andreasschegg/Door/hardware/esp-pinout.png

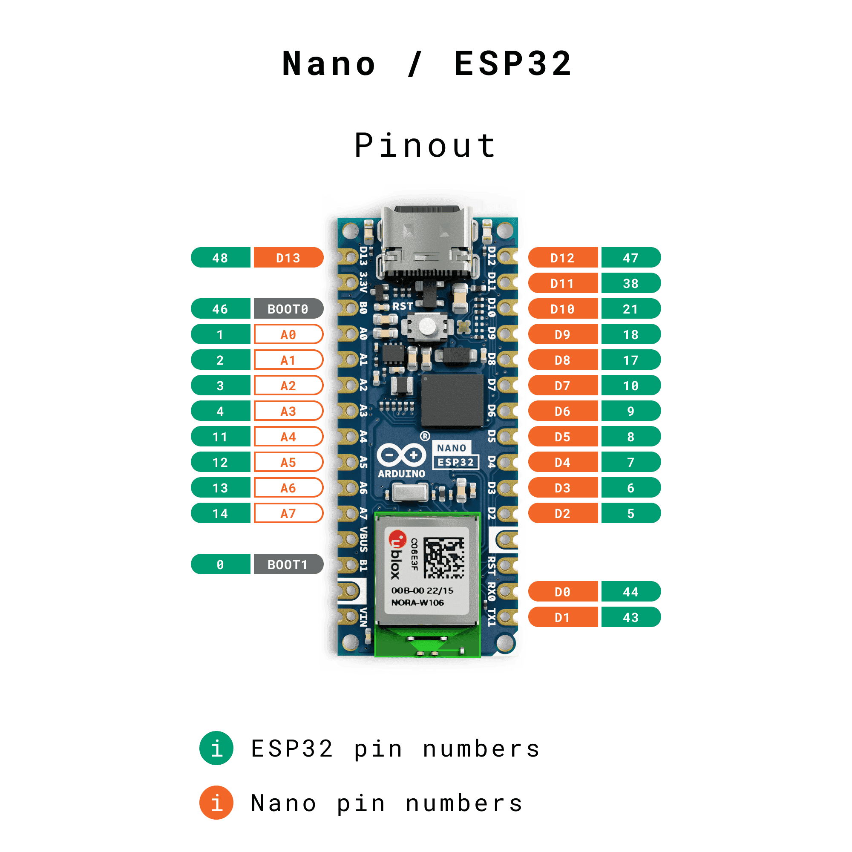
hardware/esp-pinout.png
