andreasschegg/Door/hardware/bb-stop-test.stl

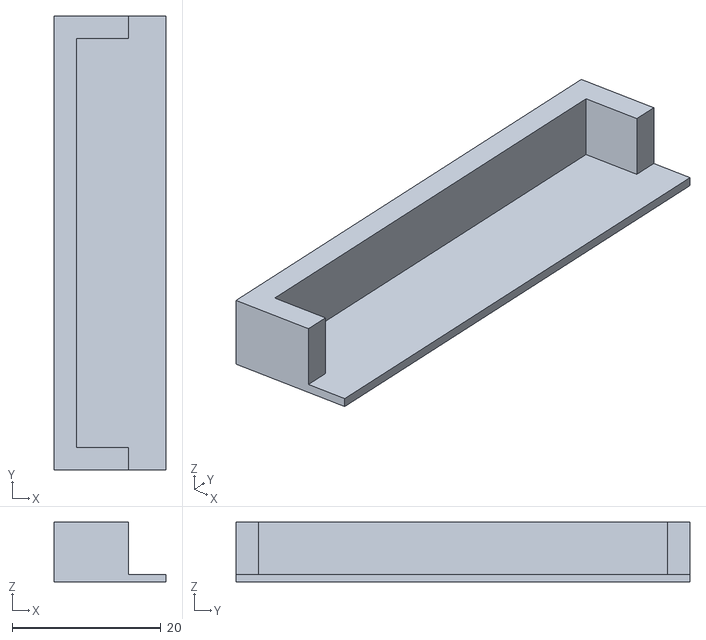
[picture p2: CAD file, 2026-03-22]
hardware/bb-stop-test.stl
15.0 x 61.0 x 8.00
