andreasschegg/Door/hardware/test-platform.stl

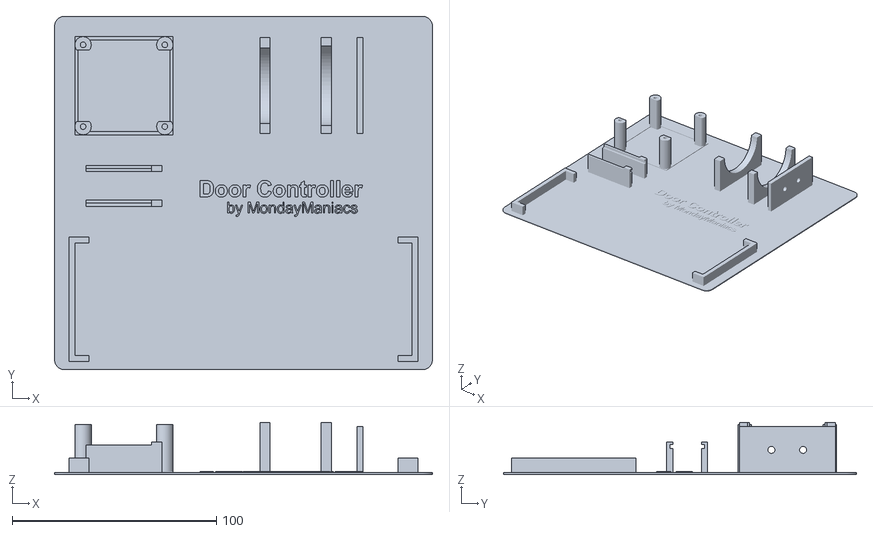
[picture p3: CAD file, 2026-03-22]
hardware/test-platform.stl
185.0 x 173.0 x 25.5
