andreasschegg/Door/hardware/motor-wall-test.stl

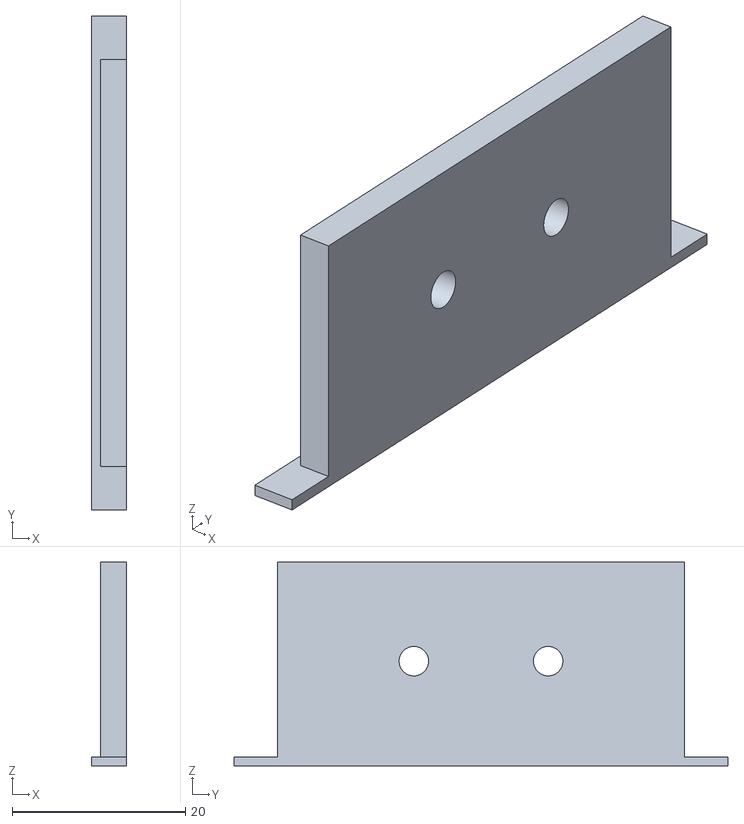
[picture p4: CAD file, 2026-03-22]
hardware/motor-wall-test.stl
4.00 x 57.0 x 23.5
