andreasschegg/Door/hardware/buck-socket-test.stl

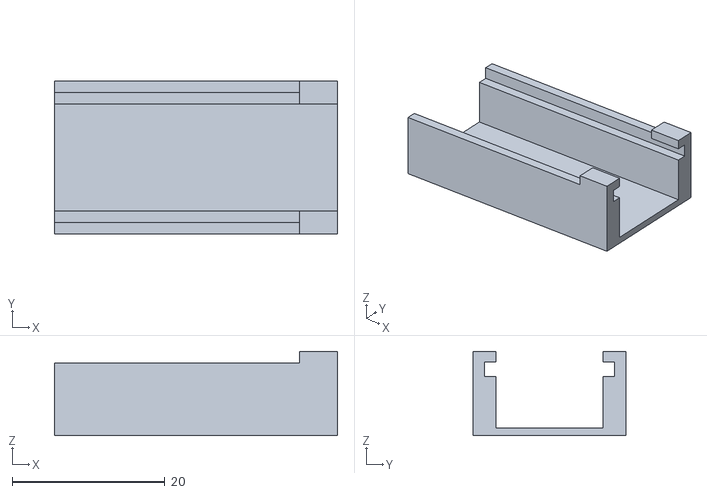
[picture p5: CAD file, 2026-03-22]
hardware/buck-socket-test.stl
37.0 x 20.0 x 11.0
