andreasschegg/Door/(commit log)

2026-03-14 Initial commit: ESP32 Door Controller
    - BTS7960 H-Bridge motor driver with abstract interface for easy swap
    - DoorController state machine (CLOSED/OPENING/OPEN/CLOSING/STOPPED/ERROR)
    - Soft-start PWM ramp, overcurrent detection, timeout safety
    - Web UI with live status and Open/Close/Stop/Reset controls
    - ArduinoOTA for wireless firmware updates
    - mDNS (http://door.local)
    [BTS7960Driver.cpp, BTS7960Driver.h, Config.h, DoorController.cpp, DoorController.h, MotorDriver.h]
2026-03-14 Add circuit protection docs and adjust current threshold for voltage divider
    - CIRCUIT.md: Full circuit documentation with component rationale
    - Config.h: CURRENT_THRESHOLD adjusted from 2000 to 1333 to account
    for the 10kΩ/20kΩ voltage divider on IS pins (factor 0.667)
2026-03-14 Add graphical circuit schematic (SVG)
    - Color-coded wiring: 12V (red), 5V (orange), signals (green/blue), GND (gray)
    - All protection components shown inline with values
    - Legend and annotations explaining each protection measure
2026-03-15 Redesign schematic for print: larger text, A3 landscape format
    - All font sizes increased ~1.7x for readability
    - Canvas sized for A3 landscape printing (420mm × 297mm)
    - Print CSS added for clean page output
    - Component symbols and spacing scaled up proportionally
2026-03-15 Redraw schematic: strict Manhattan routing, no overlaps
    - All wires strictly horizontal or vertical (no diagonal lines)
    - ESP32 and BTS7960 pins aligned at same y-coordinates for straight
    horizontal connections
    - Pull-down resistors staggered at x=640/760/880/1000 to avoid
    overlap with adjacent wires (70px spacing, 62px component height)
    - Voltage dividers for R_IS and L_IS at different x-positions
    (x=1260 and x=1100) to prevent vertical overlap
    - Motor M+/M- routed with proper right-angle corners
    - Endstop wires routed vertical-then-horizontal from GPIO pins
2026-03-15 Fix schematic: remove 5V/12V short circuit, reposition annotation
    - 5V rail now ends at x=1540 (VCC junction) instead of x=1580
    where it crossed the 12V vertical line to B+
    - Pull-down annotation moved from y=810 to y=778, clearing the
    R_IS wire at y=830
2026-03-15 Widen legend box and shift symbol column to prevent text overlap
    - Legend box width 520 → 650px
    - Symbol column shifted from x=1400 to x=1530, clearing the
    long 'Motor-Steuerung (PWM / Enable)' text on the left
2026-03-15 Move OPEN/CLOSE labels above their endstop wires
2026-03-15 Implement Approach B: DFRobot FIT0185 encoder motor support
    - New Encoder class using ESP32 PCNT hardware for quadrature decoding
    (2096 CPR, overflow handling, RPM calculation, auto-detection)
    - DoorController: CALIBRATING state, NVS persistence, position-based
    stopping, encoder auto-detect with graceful fallback to endstop-only
    - Web UI: position bar, RPM display, calibrate/clear buttons, encoder
    status indicators
    - Config: FIT0185 parameters (5A current threshold, 1200ms ramp,
    25s timeout), encoder pins GPIO 16/17
    - CIRCUIT.md: encoder wiring with level shifter, updated parts list,
    PSU 5A, calibration instructions
    - Compile-time ENCODER_ENABLED flag for backward compatibility
    Co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
2026-03-15 Update schematic: add encoder, level shifter, DFRobot FIT0185
    - ESP32 block extended with Encoder section (GPIO 16/17, purple)
    - Level Shifter block (BSS138, 5V→3.3V) between ESP32 and motor
    - Encoder signals routed with 1kΩ+100nF RC filters through level
    shifter, then under BTS7960 to motor encoder pins
    - Motor block updated: DFRobot FIT0185 with encoder pin labels
    - 5V rail supplies level shifter and encoder VCC
    - PSU updated to min. 5A
    - Legend: encoder color (purple) added
    - Footer: v2.0
2026-03-15 Remove level shifter — not needed for this use case
    1kΩ series resistor limits clamp diode current to ~1.7mA, safe for
    ESP32 inputs with 5V encoder signals. Level shifter only warranted
    for 24/7 continuous operation, not 30-40 cycles per evening.
2026-03-15 Fix encoder 5V line: route from 5V rail to motor encoder VCC
    Line was ending mid-air with old level shifter label. Now routed
    properly down and right to the motor encoder block.
2026-03-15 Reroute BTS7960 power connections to right side, add B-/GND
    - VCC (5V) and B+ (12V) now enter from the right side of the
    BTS7960 box via Manhattan routing, matching the '← 5V' / '← 12V'
    labels inside the block
    - B-/GND gets a proper pin stub on the right side with GND symbol
    - Removed old top-entry lines that pierced through the box border
2026-03-15 Redesign motor block: clear pin layout, separated connections
    - Motor+Encoder as proper block with title bar (like ESP32/BTS7960)
    - M+/M- pins on RIGHT side, routed from BTS7960 via x=2020/2060
    - Encoder Ch.A/B pins on LEFT side, connected to encoder wires
    - 5V pin on LEFT, GND pin on RIGHT with GND symbol
    - Clear divider between motor and encoder sections
    - Labels below block: FIT0185 specs + Encoder 2096 CPR
    - Endstops, legend, footer shifted down for larger canvas (1800px)
2026-03-15 Add complete bill of materials (BOM.md)
    Main components, protection circuitry, wiring/mounting supplies
    with estimated costs. Notes for motor alternatives (FIT0186, Waveshare).
2026-03-22 Change voltage divider from 20kΩ to 18kΩ (available in stock)
    - IS_R_BOTTOM: 20000 → 18000 Ohm
    - Divider ratio: 0.667 → 0.643 (3.21V max, safer margin)
    - CURRENT_THRESHOLD: 500 → 482 (same ~5A trip point)
    - Updated CIRCUIT.md calculations and BOM.md
2026-03-22 Add 3D-printable test platform (OpenSCAD)
    Mounting platform for test setup with:
    - Arduino Uno standoffs (4x M3, standard hole positions)
    - BTS7960 module standoffs (4x M3)
    - FIT0185 motor mount pad (6x M3 hex pattern, shaft hole)
    - Breadboard rails (165x55mm, side clips + front/back lips)
    - 15mm corner legs for motor shaft clearance below
    - Embossed component labels
    - Platform ~235x154mm, fits Prusa bed (250x210)
    [test-platform.scad]
2026-03-22 Switch from ESP32 to ESP32-S3-N16R8
    - platformio.ini: board esp32dev → esp32-s3-devkitc-1, COM3
    - Config.h: complete pin remap for S3 (GPIO 26-37 unavailable
    due to Octal Flash/PSRAM):
    RPWM: 25→4, LPWM: 26→5
    R_EN: 27→6, L_EN: 14→7
    R_IS: 34→1, L_IS: 35→2 (ADC1 channels)
    OPEN: 32→15, CLOSE: 33→16
    Enc.A: 16→17, Enc.B: 17→18
    - LEDC and PCNT APIs work unchanged on S3
2026-03-22 Update schematic, CIRCUIT.md and BOM for ESP32-S3 pin mapping
    - Schematic: all GPIO labels updated (25→4, 26→5, 27→6, 14→7,
    34→1, 35→2, 32→15, 33→16, 16→17, 17→18), title bar + subtitle
    updated to ESP32-S3
    - CIRCUIT.md: all pin references, overview text, ADC comments updated
    - BOM.md: ESP32 entry updated to ESP32-S3-N16R8 (44-Pin)
2026-03-22 Update remaining ESP32 references to ESP32-S3 in CIRCUIT.md
    Motor block pin labels (GPIO 17→17, 18→18) and all explanatory
    text sections updated to reference ESP32-S3 consistently.
2026-03-22 Switch to Arduino Nano ESP32 board
    - platformio.ini: board → arduino_nano_esp32, auto-detect USB port
    - Config.h: endstop pins remapped (GPIO 15/16 → GPIO 8/9, D5/D6)
    as GPIO 15-16 not exposed on Nano ESP32. All pins annotated with
    Nano pin names (A0-A3, D2-D9).
    - Schematic: title + ESP32 block label updated, GPIO 15→8, 16→9
    - CIRCUIT.md: all references updated to Arduino Nano ESP32
    - BOM.md: board entry updated
    - test-platform.scad: removed Uno mount, Nano plugs into breadboard,
    simpler layout (BTS7960 + Motor + Breadboard only)
    [test-platform.scad]
2026-03-22 Add STL export of test platform for PrusaSlicer
    153 x 143 mm platform, fits Prusa bed.
    Generated from test-platform.scad via OpenSCAD.
    [test-platform.stl]
2026-03-22 Redesign test platform: motor cradle + IBT_2 heatsink-down
    - Motor lies on its side in semicircular cradle with 3 support
    walls (left, middle, right) + 2 zip-tie bridges for securing
    - Shaft extends right beyond the platform
    - IBT_2 mounts heatsink-down with M3 through-holes, pins face up
    - Breadboard with side rails for Nano ESP32
    - Platform: 195 x 150 mm, fits Prusa bed
    [test-platform.scad, test-platform.stl]
2026-03-22 Redesign test platform v3: side-mount motor, IBT_2 on standoffs
    - Motor: 2 cradle walls + side wall with 6x M3 hex pattern holes
    and shaft clearance hole. Motor screws to wall from the side.
    - IBT_2: 4x 25mm standoff sleeves (M3), 40x40mm hole pattern.
    Board screws on top, heatsink hangs below in the air.
    - Platform: 195 x 148 mm, fits Prusa bed.
    [test-platform.scad, test-platform.stl]
2026-03-22 Swap layout rows: breadboard front, IBT_2+motor back
    - Breadboard now in front row (closest to user), flat surface
    for double-sided tape (rails removed)
    - IBT_2 + motor in back row behind breadboard
    - Fixed duplicate bb_pos assignment warning
    [test-platform.scad, test-platform.stl]
2026-03-22 Rename project to Door Manager
    Replaced all 'Door Controller' references across 6 files:
    schematic, CIRCUIT.md, BOM.md, main.cpp, WebServer, test-platform
    [test-platform.scad, test-platform.stl]
2026-03-22 Revert to Door Controller, single label on platform
    - Reverted all 'Door Manager' back to 'Door Controller'
    - Platform labels: removed IBT_2/MOTOR/BREADBOARD labels,
    replaced with single centered 'Door Controller' text
    [test-platform.scad, test-platform.stl]
2026-03-22 Center label on platform, breadboard outline is 0.6mm (flush)
    [test-platform.scad, test-platform.stl]
2026-03-22 Breadboard outline 0.6→0.4mm, shift breadboard 3mm toward user
    [test-platform.scad, test-platform.stl]
2026-03-22 Add buck converter snap-in socket between breadboard and IBT_2
    - 37x17mm PCB socket with 10mm tall rails and 1.6mm groove
    - PCB slides in from open end, rests on ledge at 8.5mm
    - Positioned in middle row with 15mm gap to breadboard and IBT_2
    - Platform height: 195 x 184mm, fits Prusa bed
    [test-platform.scad, test-platform.stl]
2026-03-22 Buck socket: align with IBT_2, clamp front/back, slide sideways
    - Socket aligned horizontally with IBT_2 center (not platform center)
    - Two walls clamp PCB front and back (along 17mm width)
    - PCB slides in sideways (along 37mm length), both ends open
    - Ledge at 8.5mm supports PCB from below
    [test-platform.scad, test-platform.stl]
2026-03-22 Buck socket: full-length rails, PCB slides in from either side
    Two 37mm rails (front + back) with groove along entire length.
    PCB slides in from left or right, clamped over the full 37mm.
    No end walls.
    [test-platform.scad, test-platform.stl]
2026-03-22 Fix buck socket: groove cuts into inner face only, not through wall
    - Wall thickness 2→3mm, groove depth 1.5mm from inner face
    - Outer 1.5mm of wall remains solid, connecting lip to base
    - Lip above groove holds PCB from above, ledge below supports it
    - PCB slides in sideways, held by groove on both rails
    [test-platform.scad, test-platform.stl]
2026-03-22 Move label to align horizontally with motor center
    [test-platform.scad, test-platform.stl]
2026-03-22 Enlarge motor shaft hole 10→14mm for 12mm shaft housing/boss
    [test-platform.scad, test-platform.stl]
2026-03-22 Reduce platform thickness 3→1.5mm to save material
    [test-platform.scad, test-platform.stl]
2026-03-22 Plate 1mm, IBT_2 standoff 23.5mm + 6.5mm metal = 30mm total
    - Plate thickness reduced to 1mm
    - Printed standoff sleeves 23.5mm for M3 metal hex standoffs
    (PC motherboard style) to screw on top
    - Total board height 30mm — enough clearance for heatsink
    [test-platform.scad, test-platform.stl]
2026-03-22 Motor cradle: different diameters for rear (35mm) and front (37mm)
    - Rear cradle wall (20%): 35mm + clearance for motor body
    - Front cradle wall (65%): 37mm + clearance for gearbox housing
    - Motor sits snug in both cradles instead of loose at the rear
    [test-platform.scad, test-platform.stl]
2026-03-22 Correct motor cradle positions to match actual motor dimensions
    - Rear cradle (ø35mm): moved from 20% to 40% (45mm from faceplate)
    - Front cradle (ø37mm): moved from 65% to 80% (15mm from faceplate)
    - Matches measured motor: 37mm near shaft, 35mm at motor body
    [test-platform.scad, test-platform.stl]
2026-03-22 Add 'by MondayManiacs' copyright below Door Controller label
    [test-platform.scad, test-platform.stl]
2026-03-22 Reduce platform margin 15→10mm, saves 5mm per side (185x176mm)
    [test-platform.scad, test-platform.stl]
2026-03-22 IBT_2 standoffs: solid pillars with 5mm blind hole for self-tap
    - Hole diameter 3.2→2.5mm (M3 self-tap pilot for PLA)
    - Blind hole only 5mm deep at the top (not through-hole)
    - Metal hex standoffs screw into the pilot hole
    - Base plate no longer needs through-holes at IBT_2 positions
    [test-platform.scad, test-platform.stl]
2026-03-22 Flatten IBT_2 standoff inner faces by 1mm for heatsink clearance
    Each of the 4 standoffs is cut flat on both inner-facing sides
    (toward the center of the 40x40 pattern), giving the heatsink
    2mm more clearance in each direction.
    [test-platform.scad, test-platform.stl]
2026-03-22 Rotate standoff flats 90°: only X-inner faces cut for heatsink
    Flattened only the left/right inner faces (X-direction) of each
    standoff, not front/back. Heatsink clearance in correct direction.
    [test-platform.scad, test-platform.stl]
2026-03-22 Standoff flats: front/back (Y-direction) for heatsink clearance
    [test-platform.scad, test-platform.stl]
2026-03-22 Increase standoff flat to 1.5mm for more heatsink clearance
    [test-platform.scad, test-platform.stl]
2026-03-22 Buck socket: tighten wall gap for PCB grip (clearance 0.3→-0.4mm)
    Inner wall distance now 16.6mm for 17mm PCB — groove holds the
    board instead of it falling through.
    [test-platform.scad, test-platform.stl]
2026-03-22 Buck socket: clearance=0, PCB rests on 1.5mm groove ledge
    Inner wall distance = board width (17mm). PCB slides in freely,
    edges rest on the 1.5mm deep groove ledge on each side. Lip
    above groove prevents PCB from lifting out.
    [test-platform.scad, test-platform.stl]
2026-03-22 Buck socket: wall gap 14mm so PCB sits 1.5mm in each groove
    17mm board - 2×1.5mm groove = 14mm inner wall distance.
    Board slides in from the side, each edge 1.5mm inside the groove.
    [test-platform.scad, test-platform.stl]
2026-03-22 Fix buck socket: groove was invisible due to negative calculation
    ledge_h and groove_h were using buck_clearance (-3) which made
    the groove cut dimensions negative. Separated groove geometry
    from wall gap calculation. Groove is now:
    - 1.8mm tall slot (1.5mm PCB + 0.3mm clearance)
    - 1.5mm deep into the 3mm wall
    - Ledge at 8.2mm, lip 1.8mm above
    [test-platform.scad, test-platform.stl]
2026-03-22 Buck socket: add 1.5mm lip above groove to hold PCB
    Groove was flush with wall top — no lip to prevent PCB from
    lifting out. Now: ledge at 6.7mm, groove 1.8mm, lip 1.5mm.
    PCB slides in from the side, lip clamps it from above.
    [test-platform.scad, test-platform.stl]
2026-03-22 Buck socket: walls 0.5mm closer (13.5mm gap) for snug PCB fit
    [test-platform.scad, test-platform.stl]
2026-03-22 Add buck socket test print (37x19.5x7mm, quick fit check)
    Standalone miniature version of the buck converter socket
    for verifying groove/lip/clamping fit before full platform print.
    [buck-socket-test.scad, buck-socket-test.stl]
2026-03-22 Increase MondayManiacs text size 3.5→5.5 for better print quality
    [test-platform.scad, test-platform.stl]
2026-03-22 Buck socket: walls +0.5mm wider, lip only on right 5mm
    - Clearance -3.5→-3 (14mm gap, 1.5mm per side in groove)
    - Lip removed along most of the length, only 5mm on right end
    - PCB slides in from left, lip stops it at the right end
    - Test print updated with same parameters
    [buck-socket-test.scad, buck-socket-test.stl, test-platform.scad, test-platform.stl]
2026-03-22 Rotate motor hex hole pattern 90° — two holes now horizontal
    [test-platform.scad, test-platform.stl]
2026-03-22 Motor wall: remove shaft hole, reduce height 2mm, keep bottom 4 holes
    - No shaft clearance hole needed
    - Wall 2mm lower (motor sits in cradle, wall doesn't need full height)
    - Only bottom 4 of 6 hex holes (2 horizontal + 2 lower diagonal)
    [test-platform.scad, test-platform.stl]
2026-03-22 IBT_2 holes 2.5→2.8mm, add motor wall test print
    - IBT_2 pilot holes slightly larger for easier self-tap threading
    - motor-wall-test.stl: standalone side wall (5x47x22.5mm) with
    bottom 4 hex holes for verifying motor faceplate fit
    [motor-wall-test.scad, motor-wall-test.stl, test-platform.scad, test-platform.stl]
2026-03-22 Motor wall: 3.5mm thick, 3.4mm M3 through-holes (2 holes)
    - Wall thickness 5→3.5mm
    - Motor holes 2.8→3.4mm (M3 through-hole, not self-tap)
    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
    [debug.stl, motor-wall-test.scad, motor-wall-test.stl, test-platform.scad, test-platform.stl]
2026-03-22 Buck socket walls 10→15mm total height
    [test-platform.scad, test-platform.stl]
2026-03-22 Breadboard: replace outline with 7mm side stops, 165mm apart
    Two vertical walls (3mm thick, 7mm high) on left and right,
    inner faces exactly 165mm apart. Breadboard slides in between.
    [test-platform.scad, test-platform.stl]
2026-03-22 Fix buck socket groove, motor wall 3mm, cleanup
    - Buck socket: rebuilt as single wall with groove cut + lip removal
    (groove was being filled by overlapping solid lip cube)
    - Motor side wall: 3.5→3mm thick
    - Buck test print updated with same fixed logic
    - Removed debug.stl
    [buck-socket-test.scad, buck-socket-test.stl, debug.stl, motor-wall-test.scad, motor-wall-test.stl, test-platform.scad, test-platform.stl]
2026-03-22 Add corner profiles to breadboard stops (7mm L-shaped)
    4 corner pieces at each end of the side walls, extending 7mm
    toward board center. Prevents breadboard from sliding front/back.
    [test-platform.scad, test-platform.stl]
2026-03-22 Add breadboard side stop test print (one wall + 2 corners)
    15 x 61 x 8mm test piece to verify fit before full platform print.
    [bb-stop-test.scad, bb-stop-test.stl]
2026-03-22 Fix schematic: 20kΩ → 18kΩ voltage divider resistors
    Missed updating the SVG labels when the resistor value was
    changed in Config.h and CIRCUIT.md earlier.
2026-03-22 Schematic: add Nano ESP32 pin names alongside GPIO numbers
    All ESP32 pins now show both designations:
    GPIO 4 / A3, GPIO 5 / D2, GPIO 6 / D3, GPIO 7 / D4
    GPIO 1 / A0, GPIO 2 / A1
    GPIO 17 / D8, GPIO 18 / D9
    GPIO 8 / D5, GPIO 9 / D6
    Pin mapping verified against official pins_arduino.h
    (arduino_nano_nora variant).
2026-03-22 Optimized pin layout for breadboard + wiring diagram
    Pin assignment reorganized for clean breadboard wiring:
    RIGHT side (cols 50-55): all 6 BTS7960 signals adjacent
    RPWM=D2/GPIO5, LPWM=D3/GPIO6, R_EN=D4/GPIO7,
    L_EN=D5/GPIO8, R_IS=D6/GPIO9, L_IS=D7/GPIO10
    LEFT side (cols 54-57): all 4 sensor signals adjacent
    EndstopOPEN=A0/GPIO1, EndstopCLOSE=A1/GPIO2,
    EncoderA=A2/GPIO3, EncoderB=A3/GPIO4
    New BREADBOARD.md with full wiring table and diagram.
    Nano position: D13=C60, TX/D1=G46.
2026-03-22 Update CIRCUIT.md pin numbers for optimized breadboard layout
    All 10 GPIO references updated to match new assignment:
    RPWM→GPIO5, LPWM→GPIO6, R_EN→GPIO7, L_EN→GPIO8,
    R_IS→GPIO9, L_IS→GPIO10, EndOPEN→GPIO1, EndCLOSE→GPIO2,
    EncA→GPIO3, EncB→GPIO4
2026-03-22 Add graphical breadboard wiring diagram (SVG)
    Shows Arduino Nano ESP32 placement on breadboard (D13=C60,
    TX/D1=G46) with color-coded jumper wire positions:
    - Right side (row I): BTS7960 signals (cols 50-55)
    - Left side (row B): Endstops + Encoder (cols 54-57)
    - Power: 5V (col 49), GND (col 47/49)
    Full wiring table with pin names, GPIO numbers, and wire colors.
2026-04-06 Schematic: separate RC filter components and remove redundant cap
    - Encoder RC filters: resistor and capacitor drawn as distinct series
    components instead of stacked on top of each other
    - Remove redundant 100nF bypass cap on 5V rail (local decoupling
    at ESP32 VIN is sufficient alongside the 100µF bulk cap)
